Vishal-Yadav-47/Demo_Project/BOM/BOM.xlsx

Reference | Qty | Value | Footprint | MPN
C1 | 1 | 100nF/16V | Capacitor_SMD:C_0805_2012Metric | GRM21BR71C105KA01L
C2 | 1 | 2.2uF/50V | Capacitor_SMD:C_0805_2012Metric | GCM21BM8EH225KE08L
C3 | 1 | 22uF/50V | Capacitor_SMD:CP_Elec_8x10.5 | EDT226M050S9LAA
C4 | 1 | 100nF/50V | Capacitor_SMD:C_0805_2012Metric | GCD21BR71H104KA01L
C5 | 1 | 47uF/25V | Capacitor_SMD:CP_Elec_6.3x5.4 | EDK476M025A9GAA
C6 | 1 | 10uF/25V | Capacitor_SMD:C_0805_2012Metric | GRM21BR61E106MA73L
C7,C10,C12,C15,C17,C20,C21,C23,C25,C27,C28,C32,C33,C34,C35,C36,C37,C39 | 18 | 100nF | Capacitor_SMD:C_0805_2012Metric | GCD21BR71H104KA01L
C8 | 1 | 4.7uF/25V | Capacitor_SMD:CP_Elec_4x5.4 | EDK475M025A9BAA
C9,C18 | 2 | 4.7uF/16V | Capacitor_SMD:CP_Elec_4x5.4 | UWP1C4R7MCL1GB
C11 | 1 | 10uF/16V | Capacitor_SMD:CP_Elec_5x5.4 | EEE-1CA100NR
C13 | 1 | 100pF/2kV | Capacitor_SMD:C_1812_4532Metric | C1812C103KGRACTU
C14,C16,C19,C26,C29,C31 | 6 | 1uF | Capacitor_SMD:C_0805_2012Metric | GCM21BR71H105KA03L
C22,C24,C30 | 3 | 10uF | Capacitor_SMD:C_0805_2012Metric | GRM21BR61E106MA73L
C38,C40 | 2 | 18pF | Capacitor_SMD:C_0805_2012Metric | CC0805FRNPO9BN180
D1 | 1 | SS34 | Diode_SMD:D_SMA | SS34
D2 | 1 | SMBJ26A | SMBJ26A:DIOM4336X265N | SMBJ26A
D3 | 1 | PWR_IN | LED_SMD:LED_0805_2012Metric | LTST-C170KRKT
D4 | 1 | 5V_OUT | LED_SMD:LED_0805_2012Metric | LTST-C170KRKT
D5 | 1 | ISO_5V | LED_SMD:LED_0805_2012Metric | LTST-C170KRKT
D6 | 1 | 3.3V_OUT | LED_SMD:LED_0805_2012Metric | LTST-C170KRKT
D7,D13,D14 | 3 | ESD9B3.3ST5G | Diode_SMD:D_SOD-923 | ESD9B3.3ST5G
D8 | 1 | TX_LED | LED_SMD:LED_0805_2012Metric | LTST-C170KRKT
D9 | 1 | RX_LED | LED_SMD:LED_0805_2012Metric | LTST-C170GKT
D10,D11,D12 | 3 | CDSOT23-SM712 | Package_TO_SOT_SMD:SOT-23 | CDSOT23-SM712
F1 | 1 | Polyfuse | Fuse:Fuse_2920_7451Metric | 2920L075/60MR
J1 | 1 | PWR | TerminalBlock_CUI:TerminalBlock_CUI_TB007-508-02_1x02_P5.08mm_Horizontal | TB007-508-02BE
J2 | 1 | SMA_Conn | Connector_Coaxial:SMA_Amphenol_901-143_Horizontal | SMA-J-P-H-RA-TH1
J5 | 1 | RS485 | TerminalBlock_CUI:TerminalBlock_CUI_TB007-508-03_1x03_P5.08mm_Horizontal | TB007-508-03BE
J6 | 1 | RS422 | TerminalBlock_CUI:TerminalBlock_CUI_TB007-508-05_1x05_P5.08mm_Horizontal | TB007-508-05BE
L1 | 1 | 15uH | Inductor_SMD:L_Coilcraft_XAL5050-XXX | 744393305150
L2 | 1 | 6.8uH | Inductor_SMD:L_Wuerth_MAPI-4020 | 74438335068
Q1,Q2 | 2 | BSS84 | Package_TO_SOT_SMD:SOT-23 | BSS84
R1 | 1 | 1.1M | Resistor_SMD:R_0805_2012Metric | RC0805FR-071M1L
R2,R9,R10,R11,R13,R14,R20,R21,R27,R30,R31,R32,R33 | 13 | 10K | Resistor_SMD:R_0805_2012Metric | RC0805FR-0710KL
R3 | 1 | 118K | Resistor_SMD:R_0805_2012Metric | RC0805FR-07118KL
R4,R7 | 2 | 1.5K | Resistor_SMD:R_0805_2012Metric | RC0805FR-071K5L
R5 | 1 | 200K | Resistor_SMD:R_0805_2012Metric | RC0805FR-07200KL
R6 | 1 | 22.1K | Resistor_SMD:R_0805_2012Metric | RC0805FR-0722K1L
R8 | 1 | 650 | Resistor_SMD:R_0805_2012Metric | RC0805FR-07650RL
R12,R40,R41,R42 | 4 | 22R | Resistor_SMD:R_0805_2012Metric | RC0805FR-0722RL
R15,R37 | 2 | 10k | Resistor_SMD:R_0805_2012Metric | RC0805FR-0710KL
R16,R17 | 2 | 1K | Resistor_SMD:R_0805_2012Metric | RC0805FR-071KL
R18,R19 | 2 | 270R | Resistor_SMD:R_0805_2012Metric | RC0805FR-07270RL
R22,R26 | 2 | 2.2K | Resistor_SMD:R_0805_2012Metric | RC0805FR-072K2L
R23,R25,R28,R29,R34,R36 | 6 | 10R | Resistor_SMD:R_0805_2012Metric | RC0805FR-0710RL
R24,R35 | 2 | 120R | Resistor_SMD:R_1206_3216Metric | AC1206FR-07120RL
R38 | 1 | 330R | Resistor_SMD:R_0805_2012Metric | RC0805FR-07330RL
R39 | 1 | 470R | Resistor_SMD:R_0805_2012Metric | RC0805FR-07470RL
RV1 | 1 | MOV | Varistor:RV_Disc_D7mm_W3.7mm_P5mm | V39ZA1
SW1,SW3 | 2 | RST | Button_Switch_SMD:SW_SPST_TL3305B | TL3305BF260QG
SW2 | 1 | Mode | Button_Switch_THT:SW_Slide_SPDT_Straight_CK_OS102011MS2Q | OS102011MS2Q
U1 | 1 | LMR54406DBVR | Package_TO_SOT_SMD:SOT-23-6 | LMR54406DBVR
U2 | 1 | B0505S-1WR3 | Converter_DCDC:Converter_DCDC_RECOM_R-78S-0.1_THT | B0505S-1WR3
U3 | 1 | TLV75733PDBV | Package_TO_SOT_SMD:SOT-23-5 | TLV75733PDBV
U4 | 1 | CORE1262-868M | CORE1262-868M:XCVR_CORE1262-868M | Core1262 HF
U5,U6 | 2 | THVD1452DGSR | THVD1452DGSR:SOP50P490X110-10N | THVD1452DGSR
U7 | 1 | ISO6762DWR | Package_SO:SOIC-16W_7.5x12.8mm_P1.27mm | ISO6762DWR
U8 | 1 | PIC18F67K22-I/PT | Package_QFP:TQFP-64_10x10mm_P0.5mm | PIC18F67K22-I/PT
Y1 | 1 | 20MHz | Crystal:Crystal_SMD_HC49-SD | ABLS2-20.000MHZ-D4Y-T
