Vishal-Yadav-47/Demo_Project/Demo Project.kicad_pcb

## KiCad design Demo Project.kicad_pcb (2026-10-29)

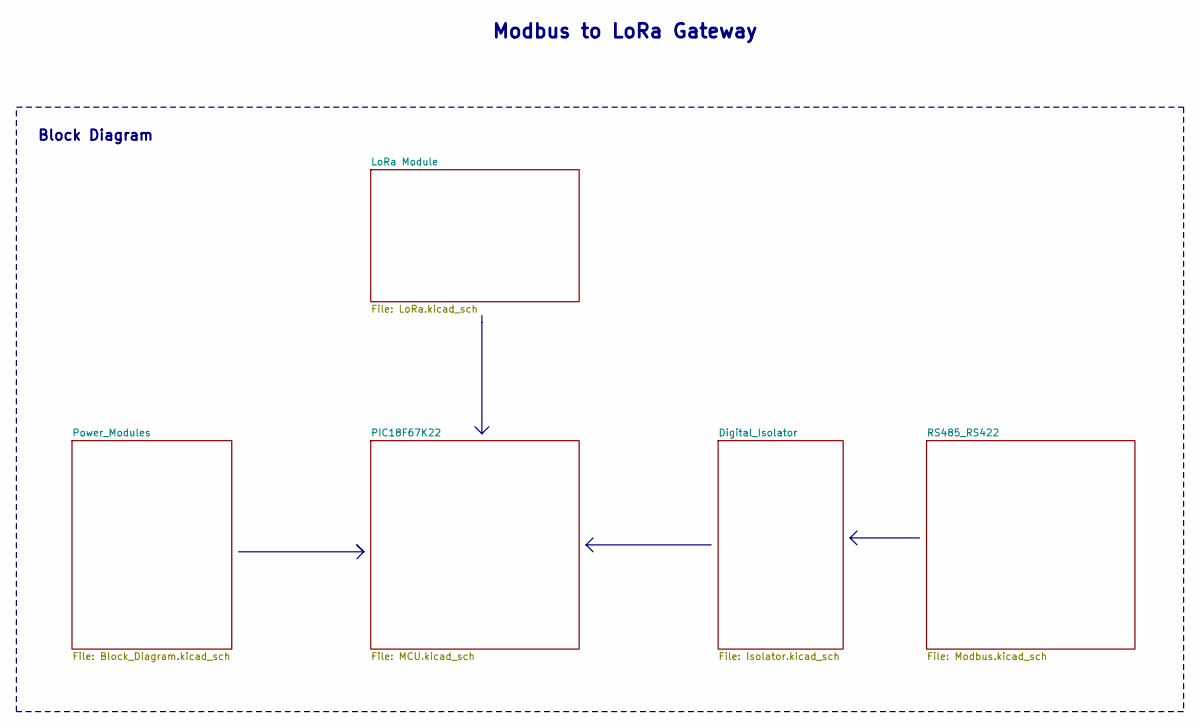
[picture p1: schematic Demo Project.kicad_sch, Modbus to LoRa Gateway]

Notes on the sheet:
Modbus to LoRa Gateway
Block Diagram

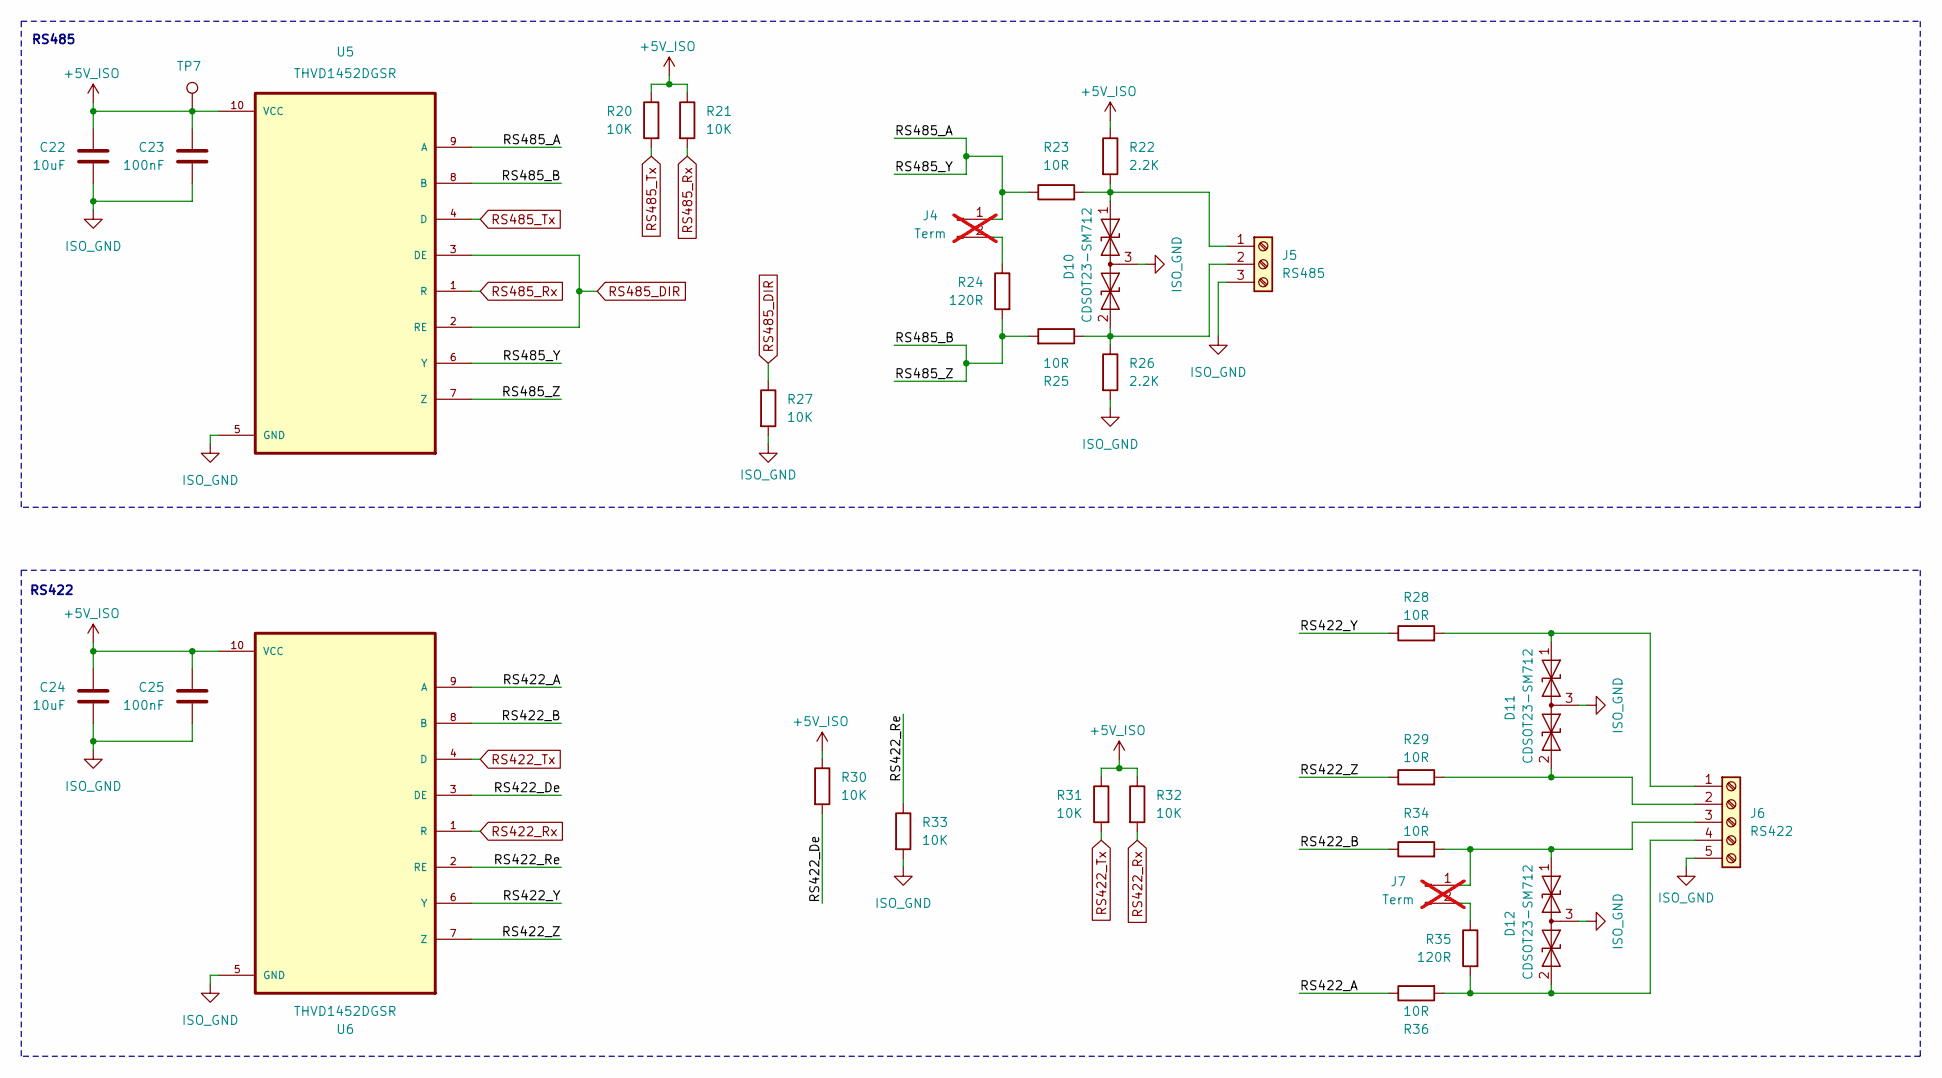
[picture p2: schematic Modbus.kicad_sch, RS485 and RS422 Transceivers]

Parts:
C22, C24: 10uF; C_0805_2012Metric
C23, C25: 100nF; C_0805_2012Metric
D10, D11, D12: CDSOT23-SM712; SOT-23
J4, J7: Term; PinHeader_1x02_P2.54mm_Vertical; not fitted
J5: RS485; TerminalBlock_CUI_TB007-508-03_1x03_P5.08mm_Horizontal
J6: RS422; TerminalBlock_CUI_TB007-508-05_1x05_P5.08mm_Horizontal
R20, R21, R27, R30, R31, R32, R33: 10K; R_0805_2012Metric
R22, R26: 2.2K; R_0805_2012Metric
R23, R25, R28, R29, R34, R36: 10R; R_0805_2012Metric
R24, R35: 120R; R_1206_3216Metric
TP7: TestPoint; TestPoint_Pad_D1.0mm
U5, U6: THVD1452DGSR; SOP50P490X110-10N

Connections:
+5V_ISO: C22.1, C23.1, C24.1, C25.1, R20.1, R21.1, R22.1, R30.1, R31.1, R32.1, TP7.1 (1_1), U5.10 (VCC), U6.10 (VCC); also elsewhere on the board
/RS485_RS422/RS422_A: R36.1, U6.9 (A)
/RS485_RS422/RS422_B: R34.1, U6.8 (B)
/RS485_RS422/RS422_De: R30.2, U6.3 (DE)
/RS485_RS422/RS422_Re: R33.1, U6.2 (RE)
/RS485_RS422/RS422_Y: R28.1, U6.6 (Y)
/RS485_RS422/RS422_Z: R29.1, U6.7 (Z)
/RS485_RS422/RS485_A: J4.1, R23.1, U5.6 (Y), U5.9 (A)
/RS485_RS422/RS485_B: R24.2, R25.2, U5.7 (Z), U5.8 (B)
ISO_GND: C22.2, C23.2, C24.2, C25.2, D10.3 (common), D11.3 (common), D12.3 (common), J5.3, J6.5, R26.2, R27.2, R33.2, U5.5 (GND), U6.5 (GND); also elsewhere on the board
unnamed: D10.1 (A1), J5.1, R22.2, R23.2
unnamed: D10.2 (A2), J5.2, R25.1, R26.1
unnamed: D11.1 (A1), J6.1, R28.2
unnamed: D11.2 (A2), J6.2, R29.2
unnamed: D12.1 (A1), J6.3, J7.1, R34.2
unnamed: D12.2 (A2), J6.4, R35.2, R36.2
unnamed: J4.2, R24.1
unnamed: J7.2, R35.1
RS422_Rx: R32.2, U6.1 (R); also elsewhere on the board
RS422_Tx: R31.2, U6.4 (D); also elsewhere on the board
RS485_DIR: R27.1, U5.2 (RE), U5.3 (DE); also elsewhere on the board
RS485_Rx: R21.2, U5.1 (R); also elsewhere on the board
RS485_Tx: R20.2, U5.4 (D); also elsewhere on the board

Notes on the sheet:
RS422
RS485

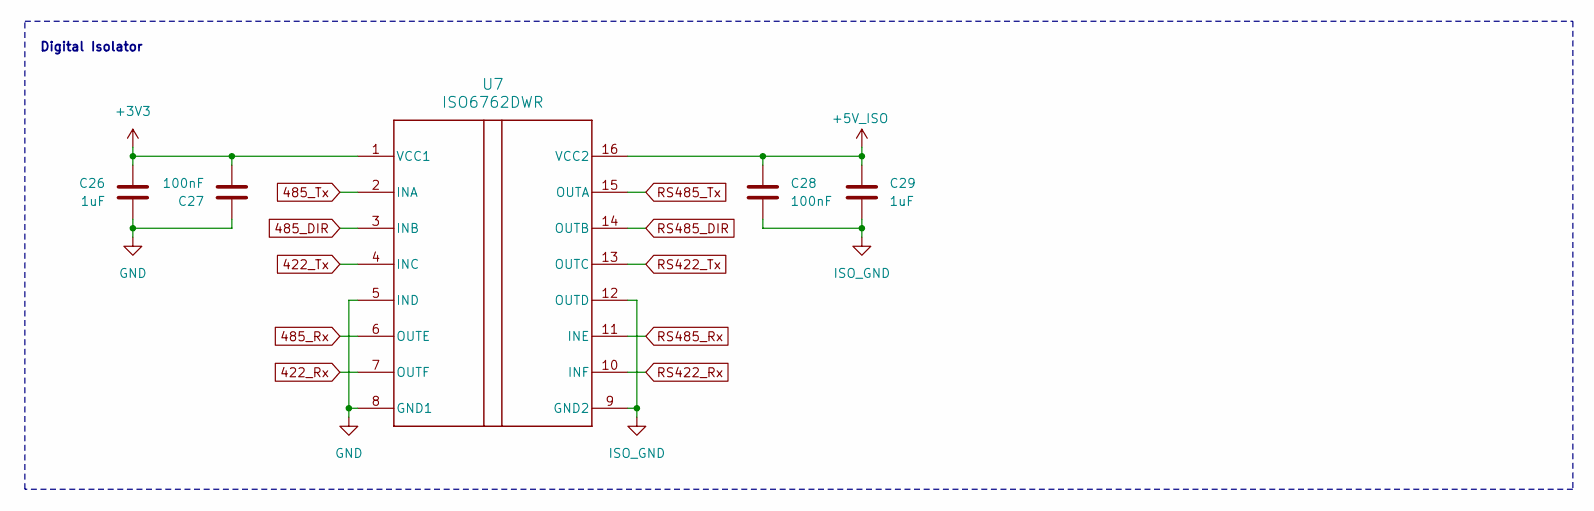
[picture p3: schematic Isolator.kicad_sch, Digital Isolator]

Parts:
C26, C29: 1uF; C_0805_2012Metric
C27, C28: 100nF; C_0805_2012Metric
U7: ISO6762DWR; SOIC-16W_7.5x12.8mm_P1.27mm

Connections:
422_Rx: U7.7 (OUTF); also elsewhere on the board
422_Tx: U7.4 (INC); also elsewhere on the board
485_DIR: U7.3 (INB); also elsewhere on the board
485_Rx: U7.6 (OUTE); also elsewhere on the board
485_Tx: U7.2 (INA); also elsewhere on the board
+3V3: C26.2, C27.2, U7.1 (VCC1); also elsewhere on the board
+5V_ISO: C28.1, C29.1, U7.16 (VCC2); also elsewhere on the board
GND: C26.1, C27.1, U7.5 (IND), U7.8 (GND1); also elsewhere on the board
ISO_GND: C28.2, C29.2, U7.9 (GND2), U7.12 (OUTD); also elsewhere on the board
RS422_Rx: U7.10 (INF); also elsewhere on the board
RS422_Tx: U7.13 (OUTC); also elsewhere on the board
RS485_DIR: U7.14 (OUTB); also elsewhere on the board
RS485_Rx: U7.11 (INE); also elsewhere on the board
RS485_Tx: U7.15 (OUTA); also elsewhere on the board

Notes on the sheet:
Digital Isolator

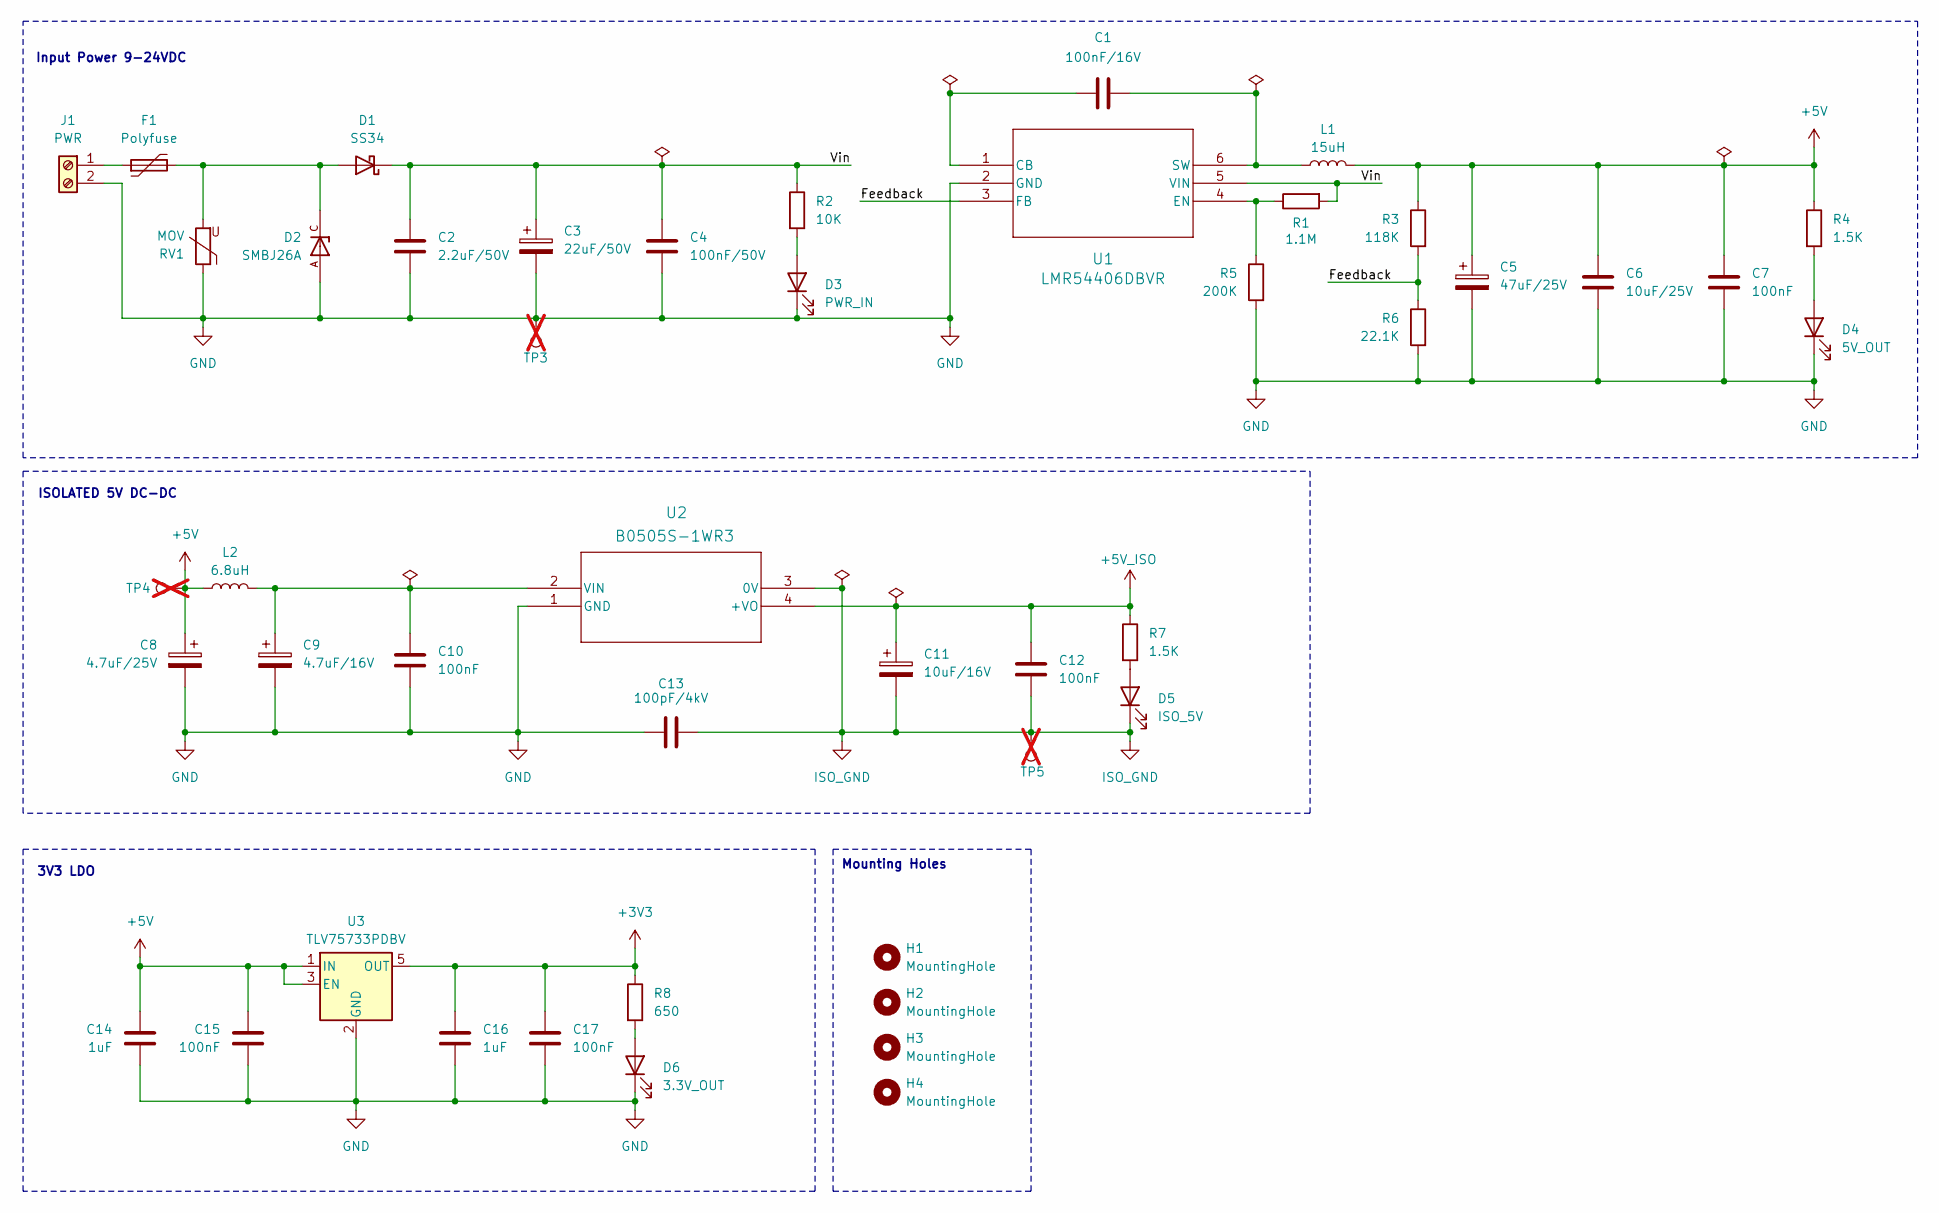
[picture p4: schematic Block_Diagram.kicad_sch, Power Block]

Parts:
C1: 100nF/16V; C_0805_2012Metric
C2: 2.2uF/50V; C_0805_2012Metric
C3: 22uF/50V; CP_Elec_8x10.5
C4: 100nF/50V; C_0805_2012Metric
C5: 47uF/25V; CP_Elec_6.3x5.4
C6: 10uF/25V; C_0805_2012Metric
C7, C10, C12, C15, C17: 100nF; C_0805_2012Metric
C8: 4.7uF/25V; CP_Elec_4x5.4
C9: 4.7uF/16V; CP_Elec_4x5.4
C11: 10uF/16V; CP_Elec_5x5.4
C13: 100pF/4kV; C_1812_4532Metric
C14, C16: 1uF; C_0805_2012Metric
D1: SS34; D_SMA
D2: SMBJ26A; DIOM4336X265N; PARTREV F2102
D3: PWR_IN; LED_0805_2012Metric
D4: 5V_OUT; LED_0805_2012Metric
D5: ISO_5V; LED_0805_2012Metric
D6: 3.3V_OUT; LED_0805_2012Metric
F1: Polyfuse; Fuse_2920_7451Metric
H1, H2, H3, H4: MountingHole; MountingHole_3.2mm_M3_DIN965_Pad_TopBottom
J1: PWR; TerminalBlock_CUI_TB007-508-02_1x02_P5.08mm_Horizontal
L1: 15uH; L_Coilcraft_XAL5050-XXX
L2: 6.8uH; L_Wuerth_MAPI-4020
R1: 1.1M; R_0805_2012Metric
R2: 10K; R_0805_2012Metric
R3: 118K; R_0805_2012Metric
R4, R7: 1.5K; R_0805_2012Metric
R5: 200K; R_0805_2012Metric
R6: 22.1K; R_0805_2012Metric
R8: 650; R_0805_2012Metric
RV1: MOV; RV_Disc_D7mm_W3.7mm_P5mm
TP3, TP4, TP5: TestPoint; TestPoint_Pad_D1.0mm; not fitted
U1: LMR54406DBVR; SOT-23-6
U2: B0505S-1WR3; Converter_DCDC_RECOM_R-78S-0.1_THT
U3: TLV75733PDBV; SOT-23-5

Connections:
+3V3: C16.1, C17.1, R8.1, U3.5 (OUT); also elsewhere on the board
+5V: C5.1, C6.1, C7.1, C8.1, C14.1, C15.1, L1.2, L2.1, R3.1, R4.1, TP4.1 (1_1), U3.1 (IN), U3.3 (EN)
+5V_ISO: C11.1, C12.1, R7.1, U2.4 (+VO); also elsewhere on the board
/Power_Modules/Feedback: R3.2, R6.1, U1.3 (FB)
/Power_Modules/Vin: C2.1, C3.1, C4.1, D1.1 (K), R1.2, R2.1, U1.5 (VIN)
GND: C2.2, C3.2, C4.2, C5.2, C6.2, C7.2, C8.2, C9.2, C10.2, C13.1, C14.2, C15.2, C16.2, C17.2, D2.A, D3.1 (K), D4.1 (K), D6.1 (K), J1.2, R5.2, R6.2, RV1.1, TP3.1 (1_1), U1.2 (GND), U2.1 (GND), U3.2 (GND); also elsewhere on the board
ISO_GND: C11.2, C12.2, C13.2, D5.1 (K), TP5.1 (1_1), U2.3 (0V); also elsewhere on the board
unnamed: D1.2 (A), D2.C, F1.2, RV1.2
unnamed: D3.2 (A), R2.2
unnamed: D4.2 (A), R4.2
unnamed: D5.2 (A), R7.2
unnamed: D6.2 (A), R8.2
unnamed: F1.1, J1.1
unnamed: C1.2, U1.1 (CB)
unnamed: R1.1, R5.1, U1.4 (EN)
unnamed: C1.1, L1.1, U1.6 (SW)
unnamed: C9.1, C10.1, L2.2, U2.2 (VIN)

Notes on the sheet:
Mounting Holes
ISOLATED 5V DC-DC
3V3 LDO
Input Power 9-24VDC

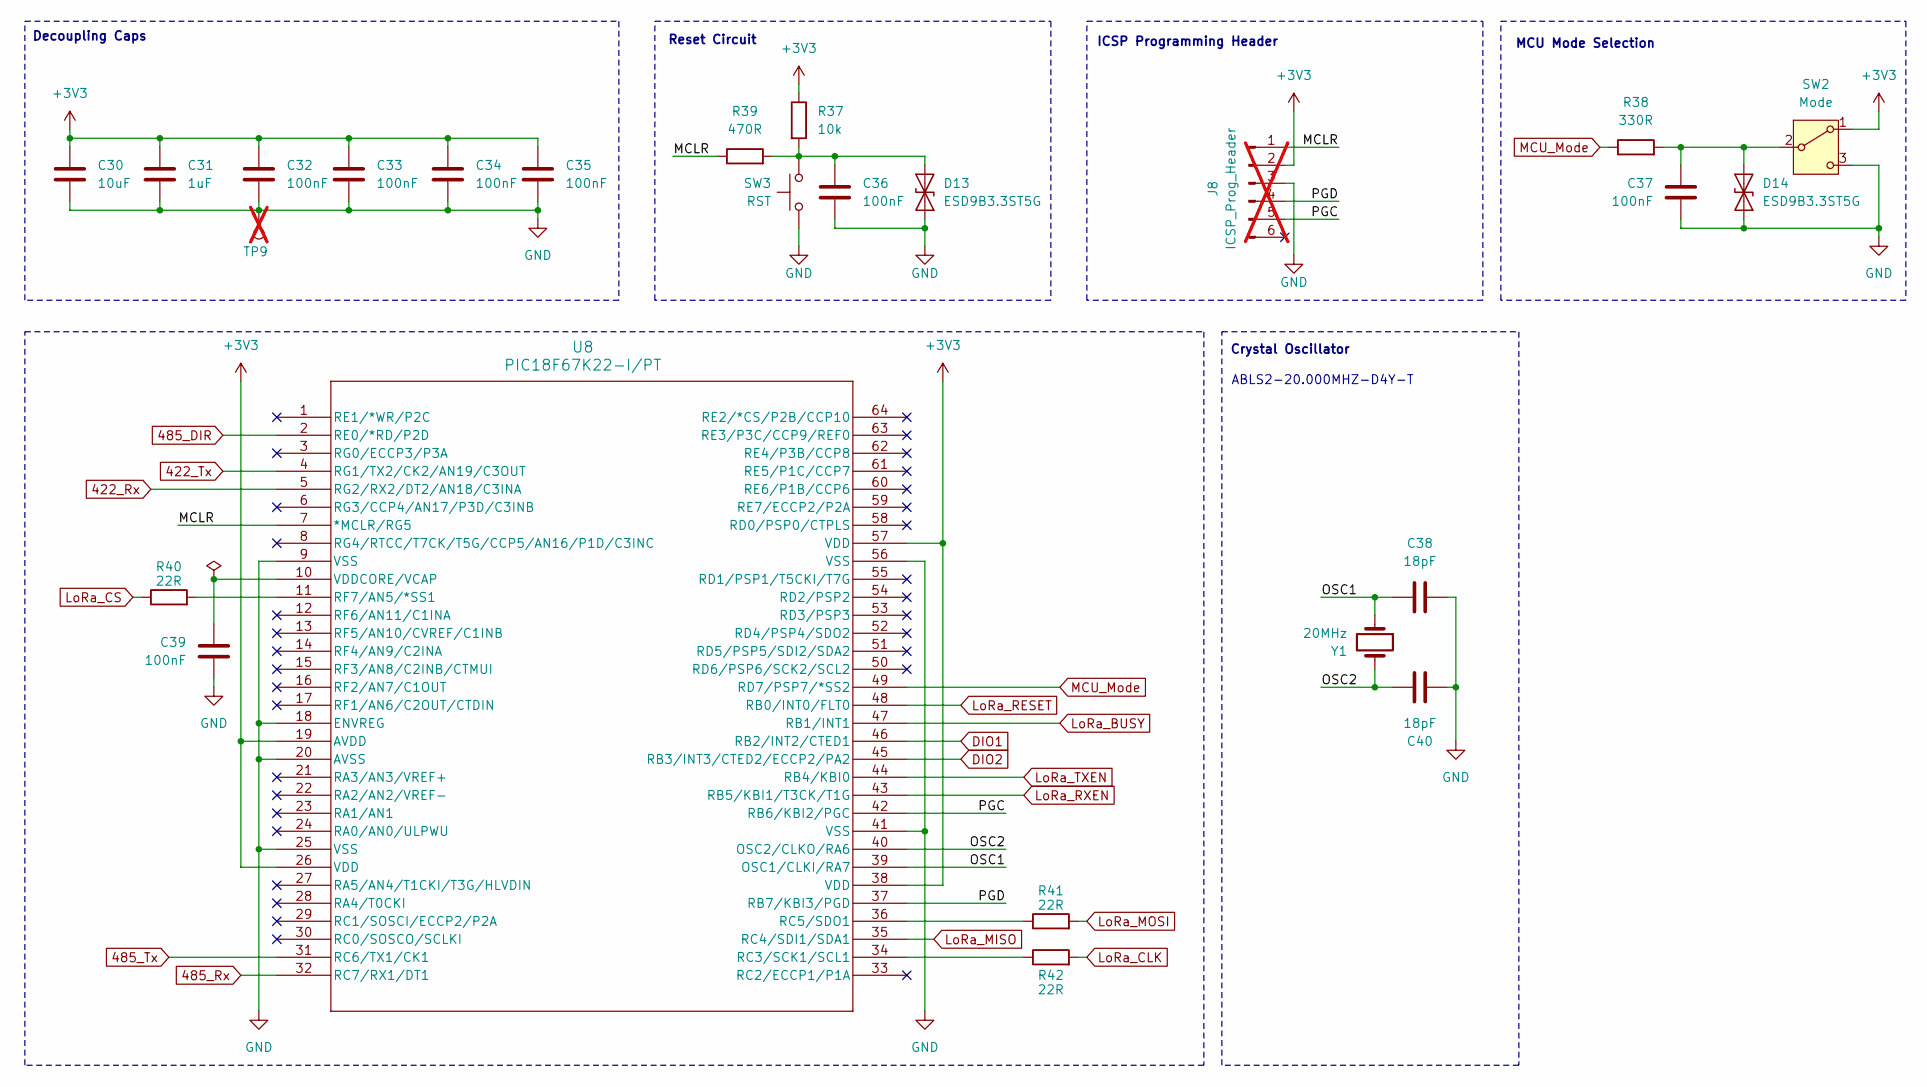
[picture p5: schematic MCU.kicad_sch]

Parts:
C30: 10uF; C_0805_2012Metric
C31: 1uF; C_0805_2012Metric
C32, C33, C34, C35, C36, C37, C39: 100nF; C_0805_2012Metric
C38, C40: 18pF; C_0805_2012Metric
D13, D14: ESD9B3.3ST5G; D_SOD-923
J8: ICSP_Prog_Header; PinHeader_1x06_P2.54mm_Vertical; not fitted
R37: 10k; R_0805_2012Metric
R38: 330R; R_0805_2012Metric
R39: 470R; R_0805_2012Metric
R40, R41, R42: 22R; R_0805_2012Metric
SW2: Mode; SW_Slide_SPDT_Straight_CK_OS102011MS2Q
SW3: RST; SW_SPST_TL3305B
TP9: TestPoint; TestPoint_Pad_D1.0mm; not fitted
U8: PIC18F67K22-I/PT; TQFP-64_10x10mm_P0.5mm
Y1: 20MHz; Crystal_SMD_HC49-SD

Connections:
422_Rx: U8.5 (RG2/RX2/DT2/AN18/C3INA); also elsewhere on the board
422_Tx: U8.4 (RG1/TX2/CK2/AN19/C3OUT); also elsewhere on the board
485_DIR: U8.2 (RE0/*RD/P2D); also elsewhere on the board
485_Rx: U8.32 (RC7/RX1/DT1); also elsewhere on the board
485_Tx: U8.31 (RC6/TX1/CK1); also elsewhere on the board
+3V3: C30.1, C31.1, C32.1, C33.1, C34.1, C35.1, J8.2, R37.1, SW2.1 (A), U8.19 (AVDD), U8.26 (VDD), U8.38 (VDD), U8.57 (VDD); also elsewhere on the board
/PIC18F67K22/MCLR: J8.1, R39.1, U8.7 (*MCLR/RG5)
/PIC18F67K22/OSC1: C38.1, U8.39 (OSC1/CLKI/RA7), Y1.1
/PIC18F67K22/OSC2: C40.2, U8.40 (OSC2/CLKO/RA6), Y1.2
/PIC18F67K22/PGC: J8.5, U8.42 (RB6/KBI2/PGC)
/PIC18F67K22/PGD: J8.4, U8.37 (RB7/KBI3/PGD)
DIO1: U8.46 (RB2/INT2/CTED1); also elsewhere on the board
DIO2: U8.45 (RB3/INT3/CTED2/ECCP2/PA2); also elsewhere on the board
GND: C30.2, C31.2, C32.2, C33.2, C34.2, C35.2, C36.2, C37.2, C38.2, C39.2, C40.1, D13.1 (A1), D14.1 (A1), J8.3, SW2.3 (C), SW3.2, TP9.1 (1_1), U8.9 (VSS), U8.18 (ENVREG), U8.20 (AVSS), U8.25 (VSS), U8.41 (VSS), U8.56 (VSS); also elsewhere on the board
LoRa_BUSY: U8.47 (RB1/INT1); also elsewhere on the board
LoRa_CLK: R42.2; also elsewhere on the board
LoRa_CS: R40.1; also elsewhere on the board
LoRa_MISO: U8.35 (RC4/SDI1/SDA1); also elsewhere on the board
LoRa_MOSI: R41.2; also elsewhere on the board
LoRa_RESET: U8.48 (RB0/INT0/FLT0); also elsewhere on the board
LoRa_RXEN: U8.43 (RB5/KBI1/T3CK/T1G); also elsewhere on the board
LoRa_TXEN: U8.44 (RB4/KBI0); also elsewhere on the board
MCU_Mode: R38.1, U8.49 (RD7/PSP7/*SS2)
unnamed: C36.1, D13.2 (A2), R37.2, R39.2, SW3.1
unnamed: C37.1, D14.2 (A2), R38.2, SW2.2 (B)
unnamed: R42.1, U8.34 (RC3/SCK1/SCL1)
unnamed: R41.1, U8.36 (RC5/SDO1)
unnamed: R40.2, U8.11 (RF7/AN5/*SS1)
unnamed: C39.1, U8.10 (VDDCORE/VCAP)

Notes on the sheet:
ICSP Programming Header
Decoupling Caps
MCU Mode Selection
Crystal Oscillator
ABLS2-20.000MHZ-D4Y-T
Reset Circuit

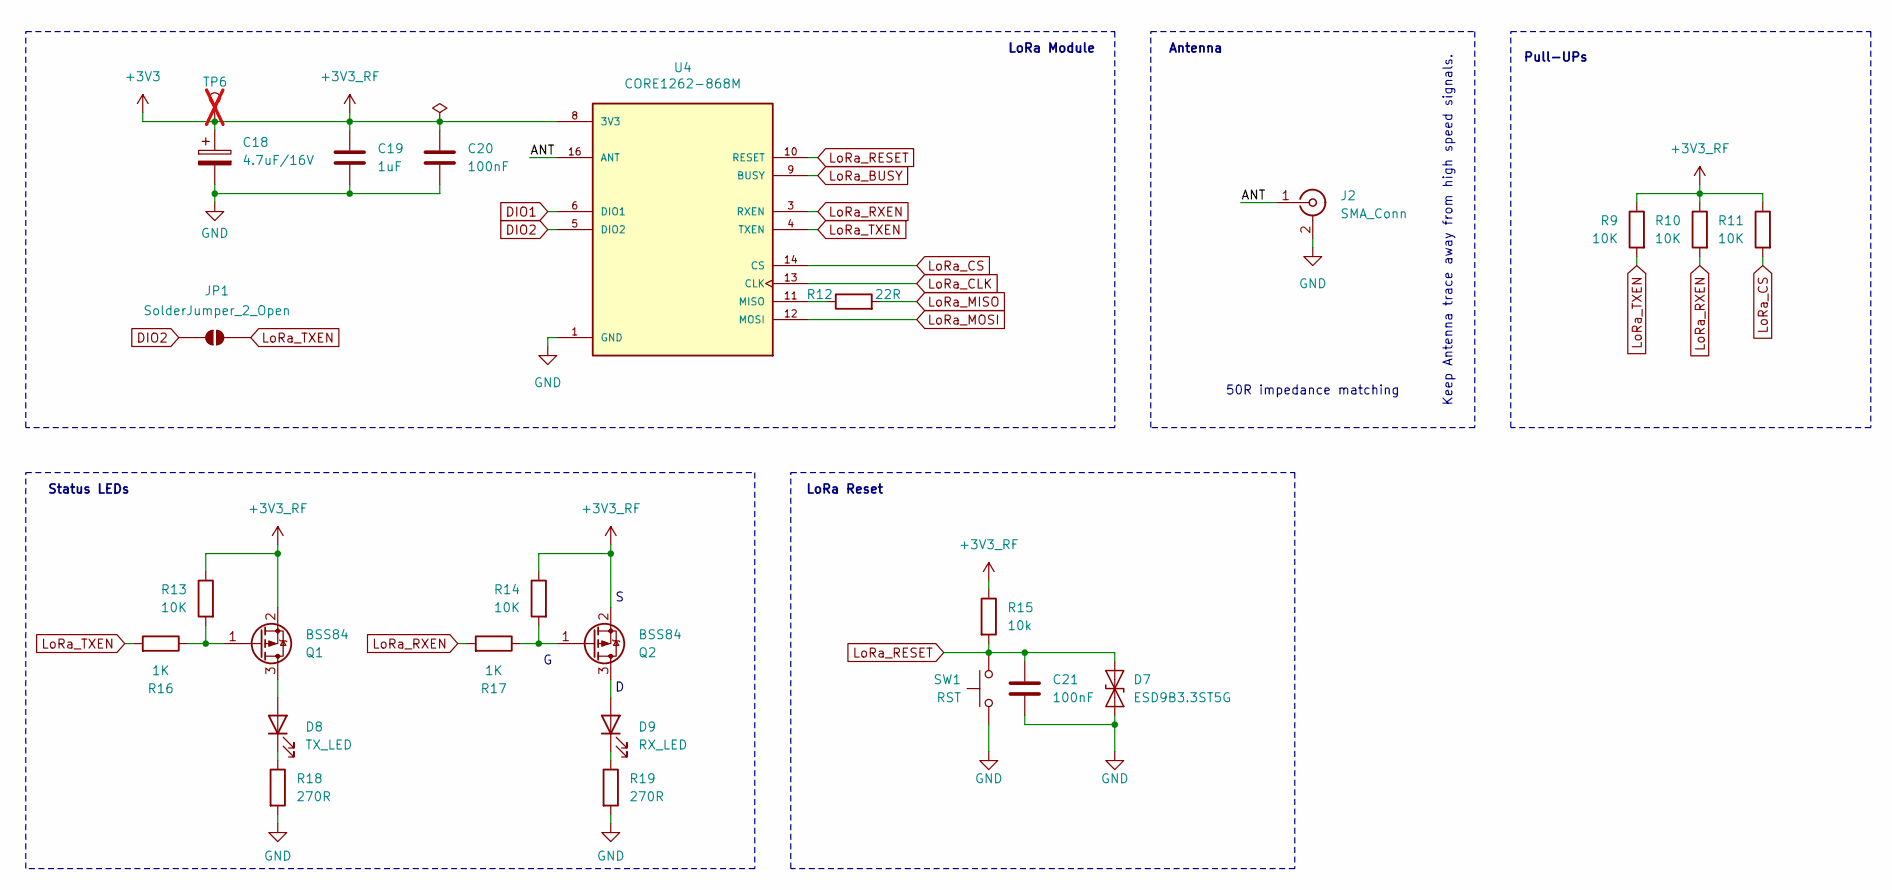
[picture p6: schematic LoRa.kicad_sch, LoRa Module]

Parts:
C18: 4.7uF/16V; C_0805_2012Metric
C19: 1uF; C_0805_2012Metric
C20, C21: 100nF; C_0805_2012Metric
D7: ESD9B3.3ST5G; D_SOD-923
D8: TX_LED; LED_0805_2012Metric
D9: RX_LED; LED_0805_2012Metric
J2: SMA_Conn; SMA_Amphenol_901-143_Horizontal
JP1: SolderJumper_2_Open; SolderJumper-2_P1.3mm_Open_TrianglePad1.0x1.5mm
Q1, Q2: BSS84; SOT-23
R9, R10, R11, R13, R14: 10K; R_0805_2012Metric
R12: 22R; R_0805_2012Metric
R15: 10k; R_0805_2012Metric
R16, R17: 1K; R_0805_2012Metric
R18, R19: 270R; R_0805_2012Metric
SW1: RST; SW_SPST_TL3305B
TP6: TestPoint; TestPoint_Pad_D1.0mm; not fitted
U4: CORE1262-868M; XCVR_CORE1262-868M; PARTREV N/A

Connections:
+3V3: C18.1, C19.1, C20.1, Q1.2 (S), Q2.2 (S), R9.1, R10.1, R11.1, R13.1, R14.1, R15.1, TP6.1 (1_1), U4.8 (3V3); also elsewhere on the board
/LoRa Module/ANT: J2.1 (In), U4.16 (ANT)
DIO1: U4.6 (DIO1); also elsewhere on the board
DIO2: JP1.2 (B), U4.5 (DIO2); also elsewhere on the board
GND: C18.2, C19.2, C20.2, C21.2, D7.1 (A1), J2.2 (Ext), R18.2, R19.2, SW1.2, U4.1 (GND), U4.2 (GND), U4.7 (GND), U4.15 (GND); also elsewhere on the board
LoRa_BUSY: U4.9 (BUSY); also elsewhere on the board
LoRa_CLK: U4.13 (CLK); also elsewhere on the board
LoRa_CS: R11.2, U4.14 (CS); also elsewhere on the board
LoRa_MISO: R12.2; also elsewhere on the board
LoRa_MOSI: U4.12 (MOSI); also elsewhere on the board
LoRa_RESET: C21.1, D7.2 (A2), R15.2, SW1.1, U4.10 (RESET); also elsewhere on the board
LoRa_RXEN: R10.2, R17.2, U4.3 (RXEN); also elsewhere on the board
LoRa_TXEN: JP1.1 (A), R9.2, R16.2, U4.4 (TXEN); also elsewhere on the board
unnamed: D8.2 (A), Q1.3 (D)
unnamed: D8.1 (K), R18.1
unnamed: D9.2 (A), Q2.3 (D)
unnamed: D9.1 (K), R19.1
unnamed: Q1.1 (G), R13.2, R16.1
unnamed: Q2.1 (G), R14.2, R17.1
unnamed: R12.1, U4.11 (MISO)

Notes on the sheet:
LoRa Module
LoRa Reset
Status LEDs
Antenna
Keep Antenna trace away from high speed signals.
50R impedance matching
Pull-UPs

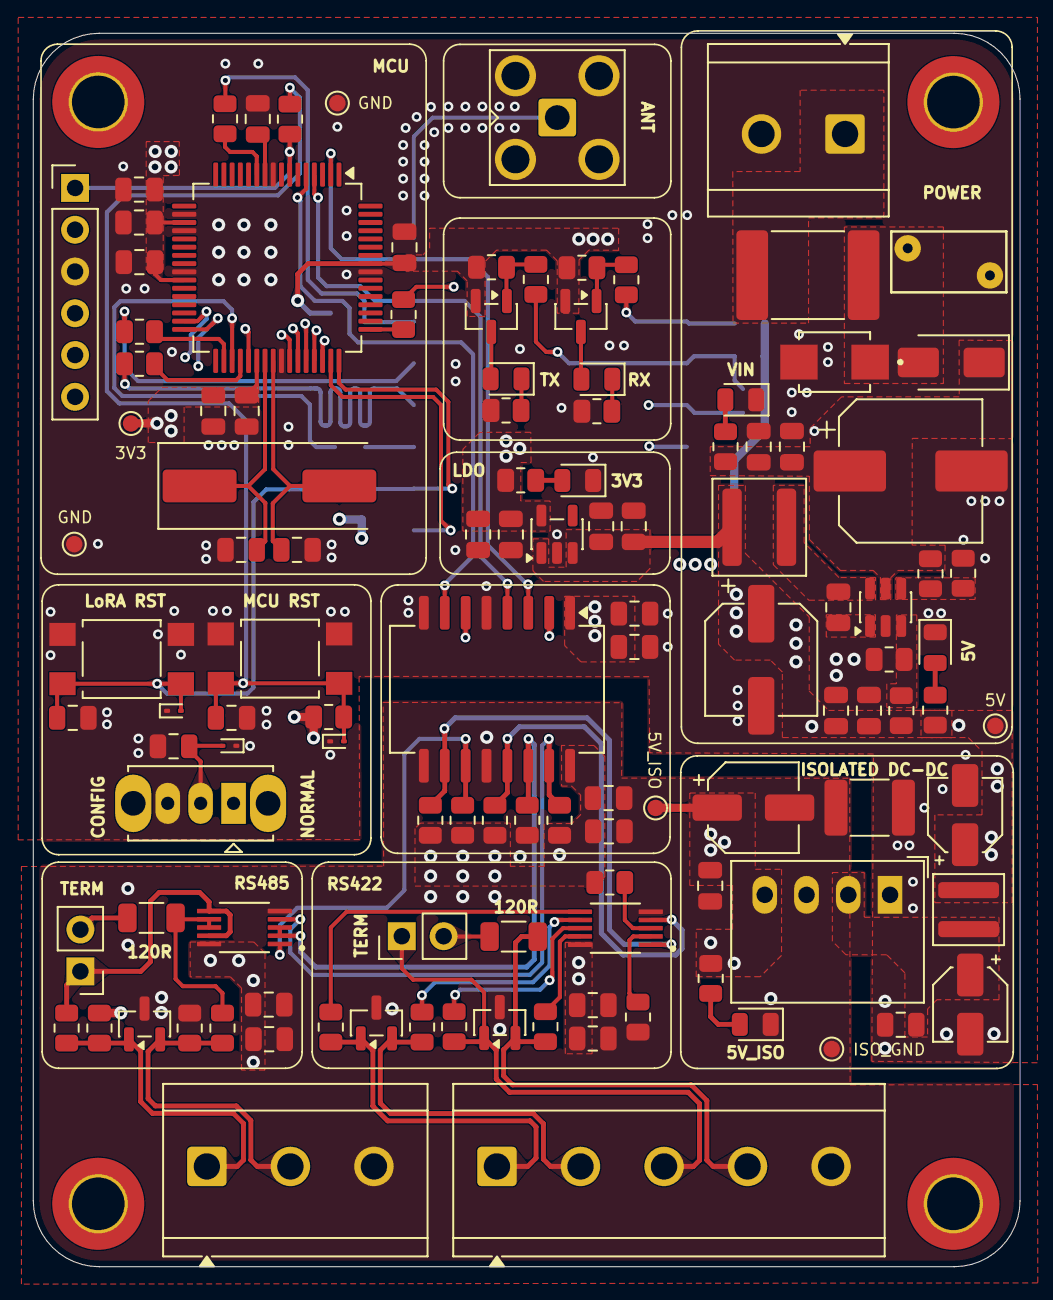
[picture p7: board Demo Project.kicad_pcb from above]

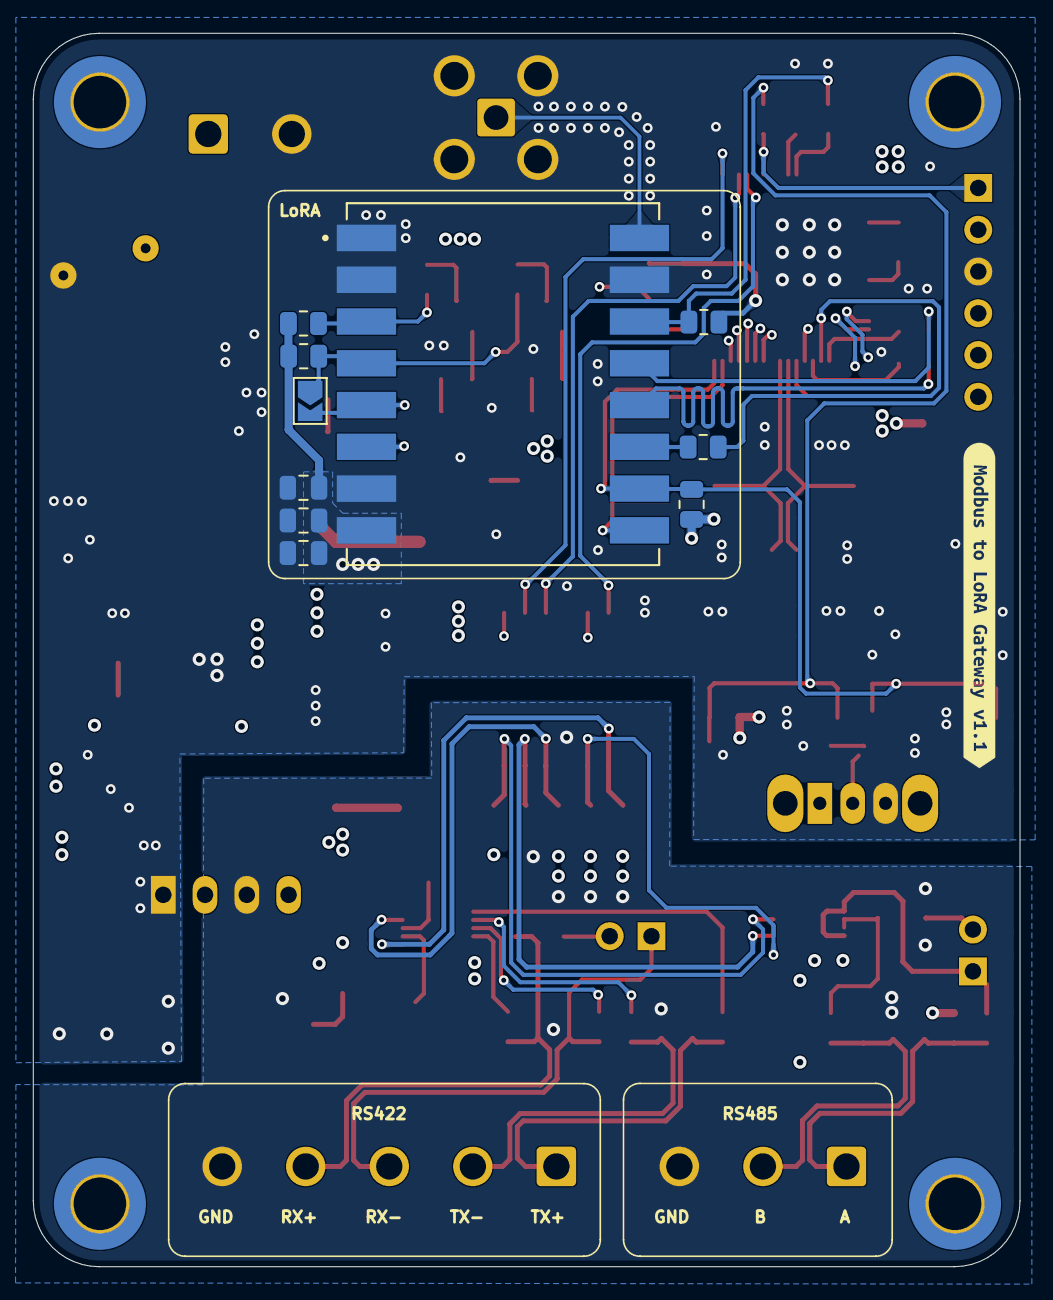
[picture p8: board Demo Project.kicad_pcb from below]

Board: 4 copper layers, 60.0 x 75.0 mm, 129 parts (11 on the bottom side), 73 nets.

Other parts of the board:
kibuzzard-6A9A594E: G***; kibuzzard-6A9A594E
