Vishal-Yadav-47/Demo_Project/(commit log)

2026-10-29 og files
    [BOM.xlsx, Block_Diagram.kicad_sch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]
2026-10-29 testing plugin
    [local revision r3 cb60daacd4a3]
    [Demo Project.kicad_pcb, LoRa.kicad_sch, MCU.kicad_sch, Modbus.kicad_sch]
2026-10-29 reverted back to og files
    [local revision r5 4274e03a1d0e]
    [Demo Project.kicad_pcb, LoRa.kicad_sch, MCU.kicad_sch, Modbus.kicad_sch]
2026-10-29 changed noting
    [local revision r6 a682fd5f1105]
    [Demo Project.kicad_pcb]
2026-10-29 nothing
    [local revision r10 a5b99bf63121]
    [Demo Project.kicad_pcb]
